zacharycho29/Zachary_BlueStampPortfolio/index.md

# Gesture-controlled Robot
This portfolio details how I built and modified a robot car that is controlled by hand gestures. Despite issues with voltage and the noncompliant HC-05 Bluetooth modules, the base project was completed ahead of schedule. This allowed me to add modifications to the project, which include video streaming over wifi and a speaker to play custom audio.

| **Engineer** | **School** | **Area of Interest** | **Grade** |
|:--:|:--:|:--:|:--:|
| Zachary C | West Essex High School | Electrical Engineering | Incoming Senior

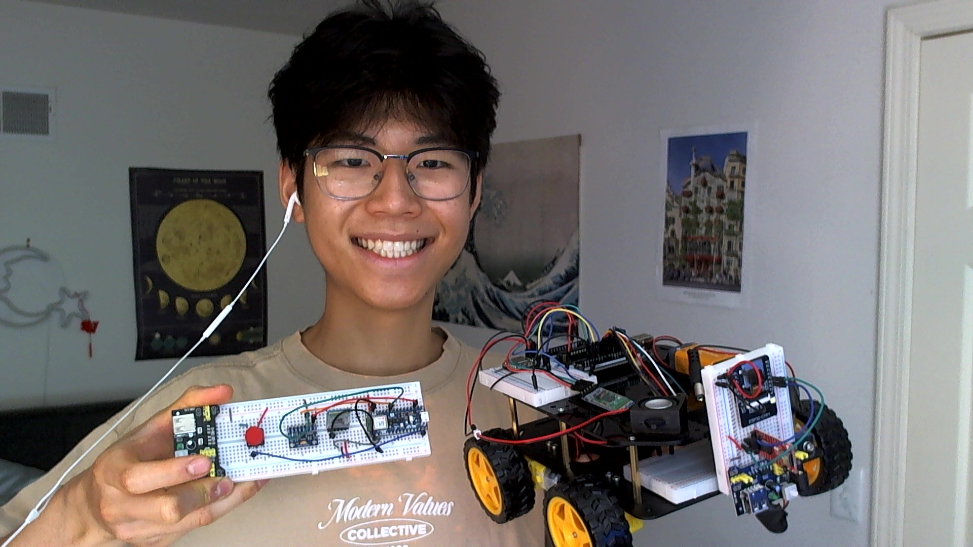
[picture p1: WIN_20260805_11_55_08_Pro.jpg]


# Final Milestone

<iframe width="560" height="315" src="https://www.youtube.com/embed/iVjtpx1hzvU?si=u30fL8y2C-zUJnvk" title="YouTube video player" frameborder="0" allow="accelerometer; autoplay; clipboard-write; encrypted-media; gyroscope; picture-in-picture; web-share" referrerpolicy="strict-origin-when-cross-origin" allowfullscreen></iframe>

### Summary

The third and final milestone centers around the modifications that I decided to add to the base project. Specifically, I landed on adding an ESP32-CAM to stream a video to a website over my local wifi, and a mini DFPlayer alongside a speaker to play custom audios at certain cues. The ESP32-CAM required an FTDI Programmer to upload code to it, and after uploading the code with the camera's "flash mode" enabled by connecting GPIO 0 to the ground pin, I disabled "flash mode" by removing the wires. Then, I reset the board, and the Serial Monitor on the Arduino IDE provided a website IP to view the stream. The ESP32-CAM is able to connect to my wifi because I input the credentials into the configuration code, which I censored on this page for privacy reasons. Moving on to the DFPlayer, I uploaded custom audio to a USB flash drive containing a MicroSD card formatted to FAT32. The MicroSD card was then inserted into the DFPlayer, which was then connected to a 3 Watt 8 Ohm speaker through jumper wires.

### Challenges

The first issue that I ran into concerned powering the ESP32-CAM without a computer connection. I made the critical error of connecting my breadboard power supply to the wrong power rails on the breadboard, causing components to short circuit, subsequently frying the ESP32-CAM. Thankfully, I had another on hand, and after fixing the wiring, I ran into no other issues with power. However, a larger issue arose when attempting to implement the mini DFPlayer into the system. The code I was attempting to run initialized two SoftwareSerial ports, one for the HC-05 Bluetooth Module and another for the mini DFPlayer, but only one SoftwareSerial port can actively listen at a time. So when one SoftwareSerial port is listening, the other stops receiving data. How this issue could be resolved was if I used an Arduino Mega, which had multiple hardware Serial ports, but with my current components I decided to leave out the mini DFPlayer.

# Second Milestone

<iframe width="560" height="315" src="https://www.youtube.com/embed/rWl_ldPpumk?si=gLNwY2qevSM6LrCk" title="YouTube video player" frameborder="0" allow="accelerometer; autoplay; clipboard-write; encrypted-media; gyroscope; picture-in-picture; web-share" referrerpolicy="strict-origin-when-cross-origin" allowfullscreen></iframe>

### Summary

The second milestone consisted of connecting and configuring the HC05 Bluetooth modules, as well as transmitting accelerometer data to move the robot in certain directions. The first step to configuring the Bluetooth modules was to get them in AT mode, where they can receive AT commands. From there, I input various commands to make the Nano's HC05 the sender, and the Uno's HC05 the receiver. To pair them, I used an AT+ADDR? to find the specific address of the receiver, and an AT+PAIR with that address to pair them. Next, I set them to communicate on the same UART baud rate of 38400. Once they were configured, I tested whether they were actually communicating by sending data from the Nano's HC05 to the Uno's HC05 and observing if the data appeared on the Uno's Serial Monitor. Moving on to the accelerometer, the wiring was relatively simple. The accelerometer measures tilt, orientation, and acceleration. These values are all transmitted to an Arduino Nano, which sends the data through the HC05 Bluetooth module to the receiver on the robot. The Arduino Uno reads these values, and if they pass certain thresholds, it will signal the motor drivers to power specific motors, moving the robot in various directions.

### Challenges

While configuring and connecting the HC05 Bluetooth Modules was not too difficult, I had issues with actually getting them to communicate. The problem I kept hitting was that the Nano would be sending messages, but the Uno would not be receiving any data. The issue lay in the fact that the Arduino Nano 33 BLE Sense that I received did not output 5V by default; it output 3.3V. Thinking that it output 5V, I wired a voltage divider between my Nano's TX pin and the HC05's RXD pin so that the RXD pin would receive 3.3V, thus avoiding frying the chip. However, since the Nano was already outputting 3.3V, I was lowering the voltage below the threshold needed for the HC05 to work. The simple fix was to just get rid of the voltage divider and wire the Nano's TX pin directly to the HC05's RXD pin. I also encountered a debounce issue with the accelerometer: the signal fluctuated near the threshold angle, causing erratic movement from rapid, opposite-direction commands. Adding a simple debounce timer in the code fixed this by ignoring direction signals that changed too quickly.

# First Milestone

<iframe width="560" height="315" src="https://www.youtube.com/embed/ZgMsRAHnwXw?si=bXjg2w3ZC6Q_6f5u" title="YouTube video player" frameborder="0" allow="accelerometer; autoplay; clipboard-write; encrypted-media; gyroscope; picture-in-picture; web-share" referrerpolicy="strict-origin-when-cross-origin" allowfullscreen></iframe>

### Summary

My first milestone focused on building the robot and wiring it together. I screwed each motor into the chassis's bottom frame to ensure a stable, secure hold. Then I connected each of the four motors to a motor driver, which was then wired to an Arduino Uno. The Arduino Uno served as the controller for the motors, and the motor driver bridged the Arduino to the gearbox motors. I then powered the motors by directly connecting a 9V battery to a breadboard's power rails, then using male-to-female jumper wires to connect the breadboard power rails to the motor driver's power input. All of the components on the robot were secured through screws or Velcro tape. I attached the top of the robot chassis and powered the Arduino with another 9V battery, this time using a barrel connector. The robot chassis build tutorial included a file that I downloaded and uploaded to the Arduino. This code was used to test the motors, ensuring that they can be powered synchronously, moving the robot forward, backward, left, and right.

### Challenges

The motors require a lot of power to run all at once, and the breadboard power supply could only supply a maximum of 5V. To ensure that all four motors received enough power, all 9V needed to be utilized from the battery. So I cut off the barrel connector on the battery attachment and stripped the wires to expose the stranded copper wire. I then soldered the stranded wires together so that they can be easily inserted into the breadboard power rails, then I wired it to the motor driver to power all of the motors.

# Schematics 

## Camera Schematic

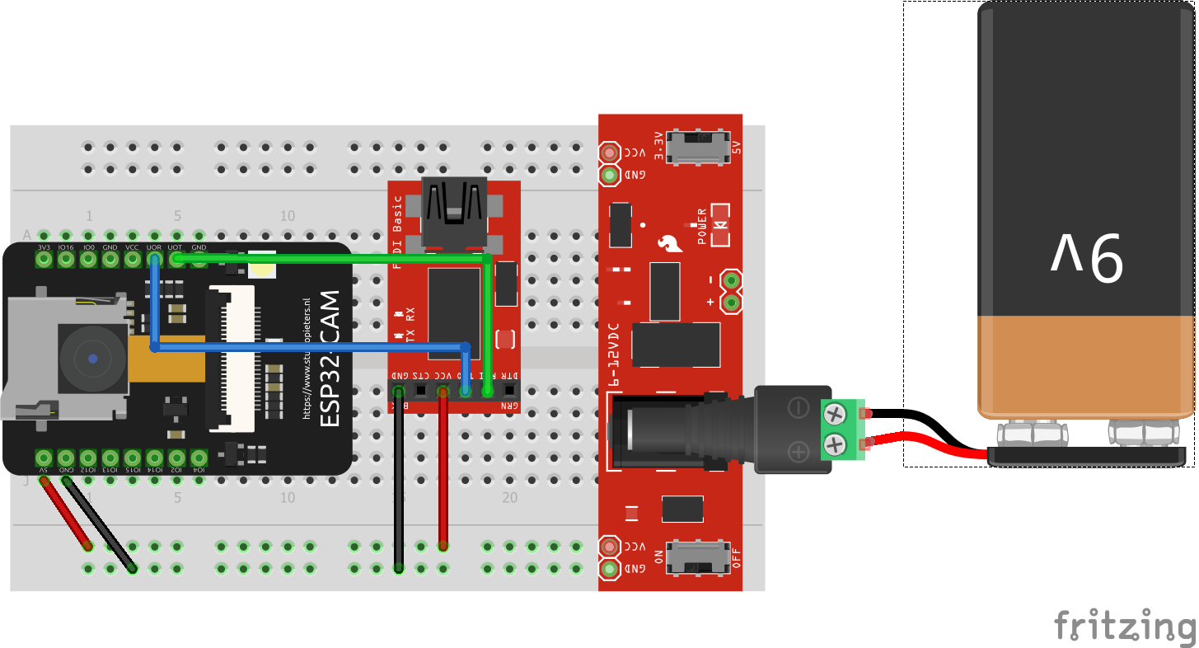
[picture p2: CameraSchematic2.png]


## Hand Module Schematic

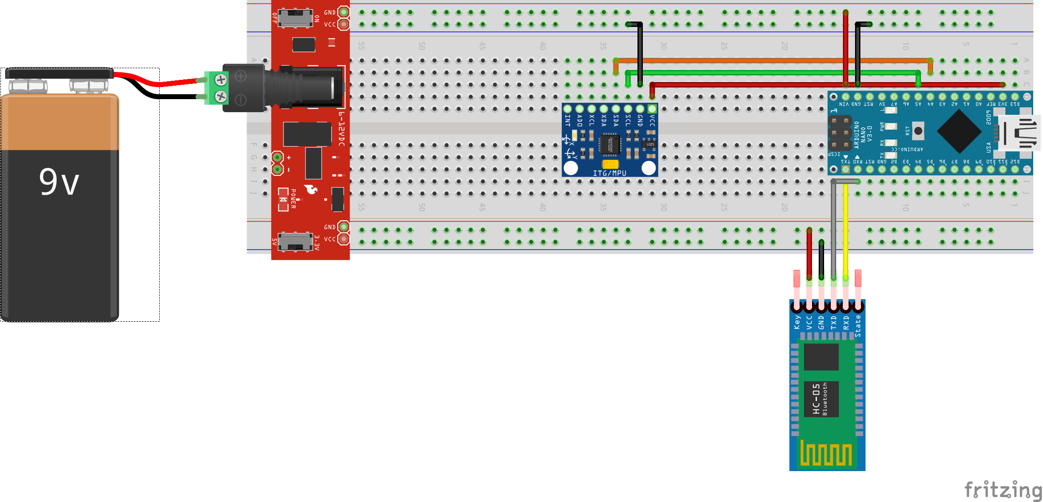
[picture p3: HandModule2.png]


## Robot Schematic

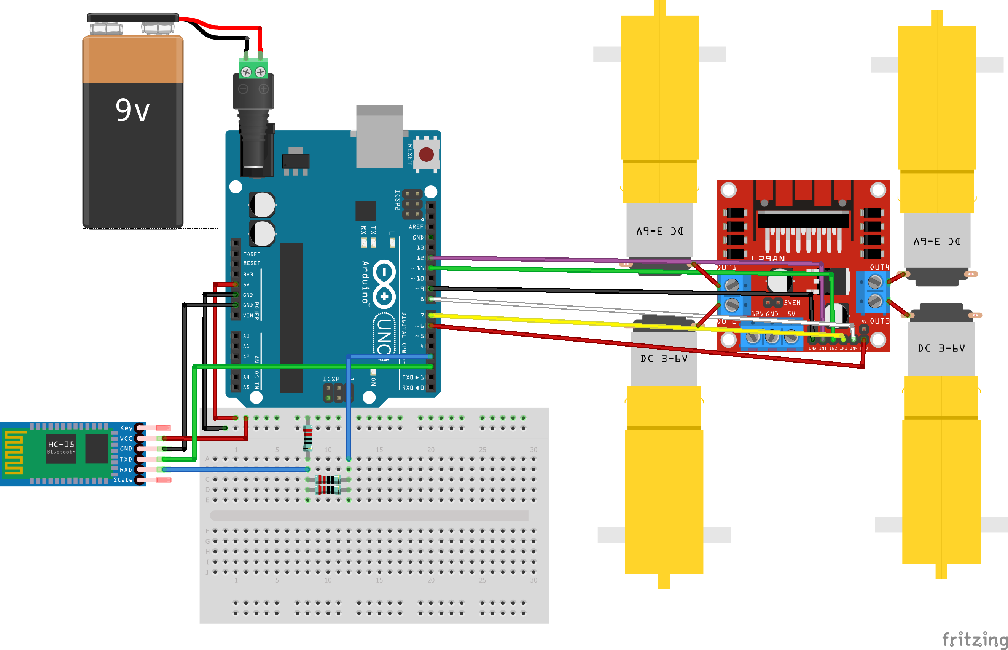
[picture p4: RobotSchematic3.png]


# Code

### Final Robot Code

```c++
#include <SoftwareSerial.h>

SoftwareSerial BT(2, 3);   // RX, TX

// L298N Pins
#define ENA 9
#define IN1 12
#define IN2 11
#define IN3 7
#define IN4 8
#define ENB 6

const int SPEED = 200;

void setup() {

  Serial.begin(9600);
  BT.begin(38400);

  pinMode(ENA, OUTPUT);
  pinMode(IN1, OUTPUT);
  pinMode(IN2, OUTPUT);
  pinMode(IN3, OUTPUT);
  pinMode(IN4, OUTPUT);
  pinMode(ENB, OUTPUT);

  stopMotors();
}

void loop() {

  if (BT.available()) {

    char dir = BT.read();

    Serial.print("Received: ");
    Serial.println(dir);

    switch (dir) {

      case 'F':
        forward();
        break;

      case 'B':
        backward();
        break;

      case 'L':
        left();
        break;

      case 'R':
        right();
        break;

      case 'n':
        stopMotors();
        break;
    }
  }
}

void forward() {

  analogWrite(ENA, SPEED);
  analogWrite(ENB, SPEED);

  digitalWrite(IN1, HIGH);
  digitalWrite(IN2, LOW);

  digitalWrite(IN3, HIGH);
  digitalWrite(IN4, LOW);
}

void backward() {

  analogWrite(ENA, SPEED);
  analogWrite(ENB, SPEED);

  digitalWrite(IN1, LOW);
  digitalWrite(IN2, HIGH);

  digitalWrite(IN3, LOW);
  digitalWrite(IN4, HIGH);
}

void left() {

  analogWrite(ENA, SPEED);
  analogWrite(ENB, SPEED);

  // Left wheel backwards
  digitalWrite(IN1, LOW);
  digitalWrite(IN2, HIGH);

  // Right wheel forwards
  digitalWrite(IN3, HIGH);
  digitalWrite(IN4, LOW);
}

void right() {

  analogWrite(ENA, SPEED);
  analogWrite(ENB, SPEED);

  // Left wheel forwards
  digitalWrite(IN1, HIGH);
  digitalWrite(IN2, LOW);

  // Right wheel backwards
  digitalWrite(IN3, LOW);
  digitalWrite(IN4, HIGH);
}

void stopMotors() {

  analogWrite(ENA, 0);
  analogWrite(ENB, 0);

  digitalWrite(IN1, LOW);
  digitalWrite(IN2, LOW);

  digitalWrite(IN3, LOW);
  digitalWrite(IN4, LOW);
}
```

### Final Hand Module Code

```c++
#include <Wire.h>
#include <Adafruit_MPU6050.h>
#include <Adafruit_Sensor.h>

Adafruit_MPU6050 mpu;

const float threshold = 5.0;
long lastTime = 0;

char lastSent = ' ';

void setup() {
  Serial.begin(9600);      // USB Serial Monitor
  Serial1.begin(38400);      // HC-05 on D0/D1

  Wire.begin();

  if (!mpu.begin()) {
    Serial.println("MPU6050 not found!");
    while (1);
  }

  mpu.setAccelerometerRange(MPU6050_RANGE_8_G);

  Serial.println("Ready");
}

void loop() {

  sensors_event_t accel, gyro, temp;
  mpu.getEvent(&accel, &gyro, &temp);

  float x = accel.acceleration.x;
  float y = accel.acceleration.y;

  char currentDirection = 'n';

  if (y > threshold)
    currentDirection = 'L';
  else if (y < -threshold)
    currentDirection = 'R';
  else if (x > threshold)
    currentDirection = 'B';
  else if (x < -threshold)
    currentDirection = 'F';

  // -------- Debounce --------
  static char candidate = 'n';
  static char lastSent = 'n';
  static unsigned long changeTime = 0;

  if (currentDirection != candidate) {
    candidate = currentDirection;
    changeTime = millis();
  }

  // Only send if the direction has stayed the same
  // for at least 150 ms
  if ((millis() - changeTime) > 150 && candidate != lastSent) {
    Serial1.write(candidate);
    Serial.print("Sent: ");
    Serial.println(candidate);

    lastSent = candidate;
  }

  delay(10);
}
```

### Camera Web Server Code

```c++
#include <Arduino.h>
#include "esp_camera.h"
#include <WiFi.h>

// ===========================
// Select camera model in board_config.h
// ===========================
#include "board_config.h"

// ===========================
// Enter your WiFi credentials
// ===========================
const char *ssid = "********";
const char *password = "********";

void startCameraServer();
void setupLedFlash();

void setup() {
  Serial.begin(115200);
  Serial.setDebugOutput(true);
  Serial.println();

  camera_config_t config;
  config.ledc_channel = LEDC_CHANNEL_0;
  config.ledc_timer = LEDC_TIMER_0;
  config.pin_d0 = Y2_GPIO_NUM;
  config.pin_d1 = Y3_GPIO_NUM;
  config.pin_d2 = Y4_GPIO_NUM;
  config.pin_d3 = Y5_GPIO_NUM;
  config.pin_d4 = Y6_GPIO_NUM;
  config.pin_d5 = Y7_GPIO_NUM;
  config.pin_d6 = Y8_GPIO_NUM;
  config.pin_d7 = Y9_GPIO_NUM;
  config.pin_xclk = XCLK_GPIO_NUM;
  config.pin_pclk = PCLK_GPIO_NUM;
  config.pin_vsync = VSYNC_GPIO_NUM;
  config.pin_href = HREF_GPIO_NUM;
  config.pin_sccb_sda = SIOD_GPIO_NUM;
  config.pin_sccb_scl = SIOC_GPIO_NUM;
  config.pin_pwdn = PWDN_GPIO_NUM;
  config.pin_reset = RESET_GPIO_NUM;
  config.xclk_freq_hz = 20000000;
  config.frame_size = FRAMESIZE_UXGA;
  config.pixel_format = PIXFORMAT_JPEG;  // for streaming
  //config.pixel_format = PIXFORMAT_RGB565; // for face detection/recognition
  config.grab_mode = CAMERA_GRAB_WHEN_EMPTY;
  config.fb_location = CAMERA_FB_IN_PSRAM;
  config.jpeg_quality = 12;
  config.fb_count = 1;

  // if PSRAM IC present, init with UXGA resolution and higher JPEG quality
  //                      for larger pre-allocated frame buffer.
  if (config.pixel_format == PIXFORMAT_JPEG) {
    if (psramFound()) {
      config.jpeg_quality = 10;
      config.fb_count = 2;
      config.grab_mode = CAMERA_GRAB_LATEST;
    } else {
      // Limit the frame size when PSRAM is not available
      config.frame_size = FRAMESIZE_SVGA;
      config.fb_location = CAMERA_FB_IN_DRAM;
    }
  } else {
    // Best option for face detection/recognition
    config.frame_size = FRAMESIZE_240X240;
#if CONFIG_IDF_TARGET_ESP32S3
    config.fb_count = 2;
#endif
  }

#if defined(CAMERA_MODEL_ESP_EYE)
  pinMode(13, INPUT_PULLUP);
  pinMode(14, INPUT_PULLUP);
#endif

  // camera init
  esp_err_t err = esp_camera_init(&config);
  if (err != ESP_OK) {
    Serial.printf("Camera init failed with error 0x%x", err);
    return;
  }

  sensor_t *s = esp_camera_sensor_get();
  // initial sensors are flipped vertically and colors are a bit saturated
  if (s->id.PID == OV3660_PID) {
    s->set_vflip(s, 1);        // flip it back
    s->set_brightness(s, 1);   // up the brightness just a bit
    s->set_saturation(s, -2);  // lower the saturation
  }
  // drop down frame size for higher initial frame rate
  if (config.pixel_format == PIXFORMAT_JPEG) {
    s->set_framesize(s, FRAMESIZE_QVGA);
  }

#if defined(CAMERA_MODEL_M5STACK_WIDE) || defined(CAMERA_MODEL_M5STACK_ESP32CAM)
  s->set_vflip(s, 1);
  s->set_hmirror(s, 1);
#endif

#if defined(CAMERA_MODEL_ESP32S3_EYE)
  s->set_vflip(s, 1);
#endif

// Setup LED FLash if LED pin is defined in camera_pins.h
#if defined(LED_GPIO_NUM)
  setupLedFlash();
#endif

  WiFi.begin(ssid, password);
  WiFi.setSleep(false);

  Serial.print("WiFi connecting");
  while (WiFi.status() != WL_CONNECTED) {
    delay(500);
    Serial.print(".");
  }
  Serial.println("");
  Serial.println("WiFi connected");

  startCameraServer();

  Serial.print("Camera Ready! Use 'http://");
  Serial.print(WiFi.localIP());
  Serial.println("' to connect");
}

void loop() {
  // Do nothing. Everything is done in another task by the web server
  delay(10000);
}

```

## Testing HC05 Communication Code

### Arduino Nano BLE 33 Sense - Sender

```c++
#define BT Serial1   // HC-05 connected to RX1/TX1 (D0/D1)

unsigned long lastSend = 0;
int counter = 0;

void setup() {
  Serial.begin(9600);   // USB serial for debugging
  while (!Serial) { }     // wait for Serial Monitor

  BT.begin(38400);        // must match AT+UART=38400,0,0

  Serial.println("Nano 33 BLE Sense sender ready");
}

void loop() {
  // Send a test message every 1000 ms
  if (millis() - lastSend >= 1000) {
    lastSend = millis();

    BT.print("MSG ");
    BT.print(counter++);
    BT.print(" TIME ");
    BT.println(millis());

    Serial.println("Sent message");
  }

  // Echo anything received from the UNO back to the Serial Monitor
  while (BT.available()) {
    char c = BT.read();
    Serial.write(c);
  }
}
```

### Arduino Uno - Receiver

```c++
#include <SoftwareSerial.h>

// HC-05 connections on the UNO
// HC-05 TXD -> D2 (UNO RX)
// HC-05 RXD <- D3 (UNO TX through 5V->3.3V divider)
SoftwareSerial BT(2, 3); // RX, TX

void setup() {
  Serial.begin(9600);  // USB Serial Monitor
  BT.begin(38400);       // must match AT+UART=38400,0,0

  Serial.println("UNO receiver ready");
}

void loop() {
  // Print any data received from the Nano
  while (BT.available()) {
    char c = BT.read();
    Serial.write(c);
  }

  // Optional: type in Serial Monitor and forward to Nano
  while (Serial.available()) {
    char c = Serial.read();
    BT.write(c);
  }
}
```

## Code for Configuring HC05 Bluetooth Modules

```c++
void setup() {
  Serial.begin(9600);

  // Wait for Serial Monitor
  while (!Serial);

  // HC-05 AT mode baud rate
  Serial1.begin(38400);

  Serial.println("HC-05 AT Mode Test");
  Serial.println("Type AT commands below:");
}

void loop() {
  // Send Serial Monitor input to HC-05
  while (Serial.available()) {
    Serial1.write(Serial.read());
  }

  // Send HC-05 response to Serial Monitor
  while (Serial1.available()) {
    Serial.write(Serial1.read());
  }
}
```

## Code to Test Robot Motors

```c++
 * After running the code, smart car will go forward 2 seconds, then go backward 2
 * seconds, then left turn for 2 seconds then right turn for 2 seconds then stop. 
 * 
 */
#define speedPinR 9           //  RIGHT PWM pin connect MODEL-X ENA
#define RightMotorDirPin1 12  //Right Motor direction pin 1 to MODEL-X IN1
#define RightMotorDirPin2 11  //Right Motor direction pin 2 to MODEL-X IN2
#define speedPinL 6           // Left PWM pin connect MODEL-X ENB
#define LeftMotorDirPin1 7    //Left Motor direction pin 1 to MODEL-X IN3
#define LeftMotorDirPin2 8    //Left Motor direction pin 1 to MODEL-X IN4

/*motor control*/
void go_Advance(void)  //Forward
{
  digitalWrite(RightMotorDirPin1, HIGH);
  digitalWrite(RightMotorDirPin2, LOW);
  digitalWrite(LeftMotorDirPin1, HIGH);
  digitalWrite(LeftMotorDirPin2, LOW);
  analogWrite(speedPinL, 200);
  analogWrite(speedPinR, 200);
}
void go_Left(int t = 0)  //Turn left
{
  digitalWrite(RightMotorDirPin1, HIGH);
  digitalWrite(RightMotorDirPin2, LOW);
  digitalWrite(LeftMotorDirPin1, LOW);
  digitalWrite(LeftMotorDirPin2, HIGH);
  analogWrite(speedPinL, 200);
  analogWrite(speedPinR, 200);
  delay(t);
}
void go_Right(int t = 0)  //Turn right
{
  digitalWrite(RightMotorDirPin1, LOW);
  digitalWrite(RightMotorDirPin2, HIGH);
  digitalWrite(LeftMotorDirPin1, HIGH);
  digitalWrite(LeftMotorDirPin2, LOW);
  analogWrite(speedPinL, 200);
  analogWrite(speedPinR, 200);
  delay(t);
}
void go_Back(int t = 0)  //Reverse
{
  digitalWrite(RightMotorDirPin1, LOW);
  digitalWrite(RightMotorDirPin2, HIGH);
  digitalWrite(LeftMotorDirPin1, LOW);
  digitalWrite(LeftMotorDirPin2, HIGH);
  analogWrite(speedPinL, 200);
  analogWrite(speedPinR, 200);
  delay(t);
}
void stop_Stop()  //Stop
{
  digitalWrite(RightMotorDirPin1, LOW);
  digitalWrite(RightMotorDirPin2, LOW);
  digitalWrite(LeftMotorDirPin1, LOW);
  digitalWrite(LeftMotorDirPin2, LOW);
}
/*set motor speed */
void set_Motorspeed(int speed_L, int speed_R) {
  analogWrite(speedPinL, speed_L);
  analogWrite(speedPinR, speed_R);
}

//Pins initialize
void init_GPIO() {
  pinMode(RightMotorDirPin1, OUTPUT);
  pinMode(RightMotorDirPin2, OUTPUT);
  pinMode(speedPinL, OUTPUT);

  pinMode(LeftMotorDirPin1, OUTPUT);
  pinMode(LeftMotorDirPin2, OUTPUT);
  pinMode(speedPinR, OUTPUT);
  stop_Stop();
}

void setup() {
  init_GPIO();

  go_Advance();  //Forward

  delay(2000);

  go_Back();  //Reverse

  delay(2000);

  go_Left();  //Turn left

  delay(2000);

  go_Right();  //Turn right

  delay(2000);

  stop_Stop();  //Stop
}

void loop() {
}
```

# Bill of Materials

| **Part** | **Note** | **Price** | **Link** |
|:--:|:--:|:--:|:--:|
| Car Chassis Kit | Used as the body of the robot | $39.99 | <a href="https://www.amazon.com/dp/B0DJ7BT1V5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"> Link </a> |
| Screwdriver Kit | Tools required for assembly | $5.94 | <a href="https://www.amazon.com/Small-Screwdriver-Set-Mini-Magnetic/dp/B08RYXKJW9/"> Link </a> |
| Arduino Uno Clone | Microcontroller used to receive and process inputs/outputs | $14.98 | <a href="https://www.amazon.com/ELEGOO-Board-ATmega328P-ATMEGA16U2-Compliant/dp/B01EWOE0UU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"> Link </a> |
| Electronics Kit | Includes jumper wires, various smaller components like potentiometers, buzzers, resistors, LEDs, etc. | $14 | <a href="https://www.amazon.com/Smraza-Electronics-Potentiometer-tie-Points-Breadboard/dp/B0B62RL725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"> Link </a> |
| Breadboard Kit | Allows for solderless connections | $8.79 | <a href="https://www.amazon.com/Breadboards-Solderless-Breadboard-Distribution-Connecting/dp/B07DL13RZH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"> Link </a> |
| Arduino Nano 33 BLE Sense | Collects and transmits sensor data through bluetooth | $39.70 | <a href="https://www.amazon.com/Arduino-Nano-Sense-headers-ABX00070/dp/B0BQHZ88WD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"> Link </a> |
| Micro USB Cable | Used to connect the Arduino to the computer | $5 | <a href="https://www.amazon.com/Charging-Transfer-Android-Trustable-MYFON/dp/B098DW7485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"> Link </a> |
| Accelerometer | Acts as an input sensor to translate the hand movements to directional commands | $9 | <a href="https://www.amazon.com/dp/B0D2TJVMNY?ref=fed_asin_title"> Link </a> |
| HC05 | Acts as a wireless serial bridge, sending gesture data from the control glove | $9 | <a href="https://www.amazon.com/DSD-TECH-HC-05-Pass-through-Communication/dp/B01G9KSAF6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"> Link </a> |
| Breadboard Power Supply | Used to supply power to the breadboards | $8 | <a href="https://www.amazon.com/ALAMSCN-Solderless-Breadboard-Battery-Arduino/dp/B08JYPMCZY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"> Link </a> |
| 9V Batteries | Power Source | $8.69 | <a href="https://www.amazon.com/Amazon-Basics-Performance-All-Purpose-Batteries/dp/B00MH4QM1S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"> Link </a> |
| Velcro Tape | Allows for easy attachment and removal of parts | $8 | <a href="https://www.amazon.com/Art3d-Sticky-Double-Sided-Command-Adhesive/dp/B0B58FGF8H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"> Link </a> |
| DMM | Used for debugging and circuit analysis | $9.99 | <a href="https://www.amazon.com/dp/B0CXM242J1?ref=fed_asin_title&th=1"> Link </a> |
| ESP32-CAM | Streams video over local network | $16.99 | <a href="https://www.amazon.com/Hosyond-ESP32-CAM-Bluetooth-Development-Compatible/dp/B09TB1GJ7P/?th=1"> Link </a> |
| FTDI | Acts as a translator between the computer and ESP32-CAM | $5.99 | <a href="https://www.amazon.com/FT232RL-Serial-Adapter-Module-Arduino/dp/B0FHP71BCQ?th=1"> Link </a> |
| USB-A to USB-C Cable | Connected the computer USB-A port and FTDI USB-C port | $8.99 | <a href="https://www.amazon.com/Anker-2-Pack-Premium-Samsung-Galaxy/dp/B07DD5YHMH?th=1"> Link </a> |
| 32GB TF Memory Card | Provides offline local storage for custom audio | $14.99 | <a href="https://www.amazon.com/SECUEYE-Memory-Reading-Writing-Security/dp/B0BRSS3LRT/?th=1"> Link </a> |
| DFPlayer | Plays MP3, WAV, and WMA files directly from a Micro-SD card | $9.90 | <a href="https://www.amazon.com/dp/B089D5NLW1?lv=shuf&channelId=500&plpRedirect=mhFallback&th=1"> Link </a> |
| 3 Watt 8 Ohm Mini Speakers | Small audio driver that plays sounds | $9.99 | <a href="https://www.amazon.com/Dweii-Loundspeaker-JST-PH2-0-Electronic-Advertising/dp/B0B4D1BN4F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"> Link </a> |
| 5V / 3A Power Bank | Provides sufficient voltage and current for ESP32 wifi connection | $21.99 | <a href="amazon.com/Anker-Portable-Charger-PowerIQ-Battery/dp/B0D5CLSMFB"> Link </a> |
| USB 2.0 to UART Converter | Provides jumper wire connections to the power bank | $9.99 | <a href="[amazon.com/Anker-Portable-Charger-PowerIQ-Battery/dp/B0D5CLSMFB](https://www.amazon.com/dp/B0GWDS3VR2?ref=clp_hp_h_pc&th=1)"> Link </a> |

# Other Resources/Examples
- [Robot Chassis Build Tutorial](https://osoyoo.com/2018/12/07/new-smart-car-lesson1/)
- [Wiring Tutorial](https://www.youtube.com/watch?v=npIy5UEg34M&t=2s)
- [HC-05 Bluetooth Configuration](https://docs.google.com/document/d/1EpnEPulXQwPDSK-nKLohqPjpeXNteP2G/edit)
- [ESP32-CAM Setup](https://www.youtube.com/watch?v=g1J_7lx5QEU)
- [Fritzing ESP32-CAM Part](https://forum.fritzing.org/t/esp32-cam-fritzing-part/8517)
- [DFPlayer Setup](https://www.youtube.com/watch?v=xYU1l8w_Oe4)
