zacharycho29/Zachary_BlueStampPortfolio/(commit log)

2026-07-20 Update index.md
    Changed Bill of Materials to include parts, costs, and links
2026-07-20 Update index.md
    Added some descriptions for the Bill of Materials parts
2026-07-20 Update index.md
    Added more to BOM
2026-07-22 Update index.md
    finished BOM
2026-07-30 Camera Web Server
2026-07-30 Camera Web Server Code
    [partitions.csv]
2026-07-31 Update index.md
    added robot schematic and esp32-cam fritzing part
2026-07-31 Update index.md
    updated BOM
